bartyo/Device/Prototype/KiCAD-Files-SensorBoard/BOM_SPB_Go_Concept.xls

Part/Designator | Manufacturer Part Number/Seeed SKU | Quantity | Link
C1,C3,C4 | GRM155R60J475ME47D | 3 | https://www.digikey.com/
C2 | JMK107BJ106MA-T | 1 | https://www.digikey.com/
P1 | 61300911121 | 1 | https://www.digikey.com/
R1,R4 | RT0402BRD07200KL | 2 | https://www.digikey.com/
R2,R3 | ERA-2AED101X | 2 | https://www.digikey.com/
R5,R6,R7 | ERA-2AEB472X | 3 | https://www.digikey.com/
Rs1,Rs2 | ERJ-3RQF1R0V | 2 | https://www.digikey.com/
U1 | MAX30101EFD+T | 1 | https://www.digikey.com/
U2 | TLV70018DSER | 1 | https://www.digikey.com/
U3 | LTC6103CMS8#PBF | 1 | https://www.digikey.com/
