bartyo/Device/Prototype/KiCAD-Files-SensorBoard/Design-Files/SPB_ProjSante.kicad_pcb

## KiCad design Prototype/KiCAD-Files-SensorBoard/Design-Files/SPB_ProjSante.kicad_pcb (2019-10-11)

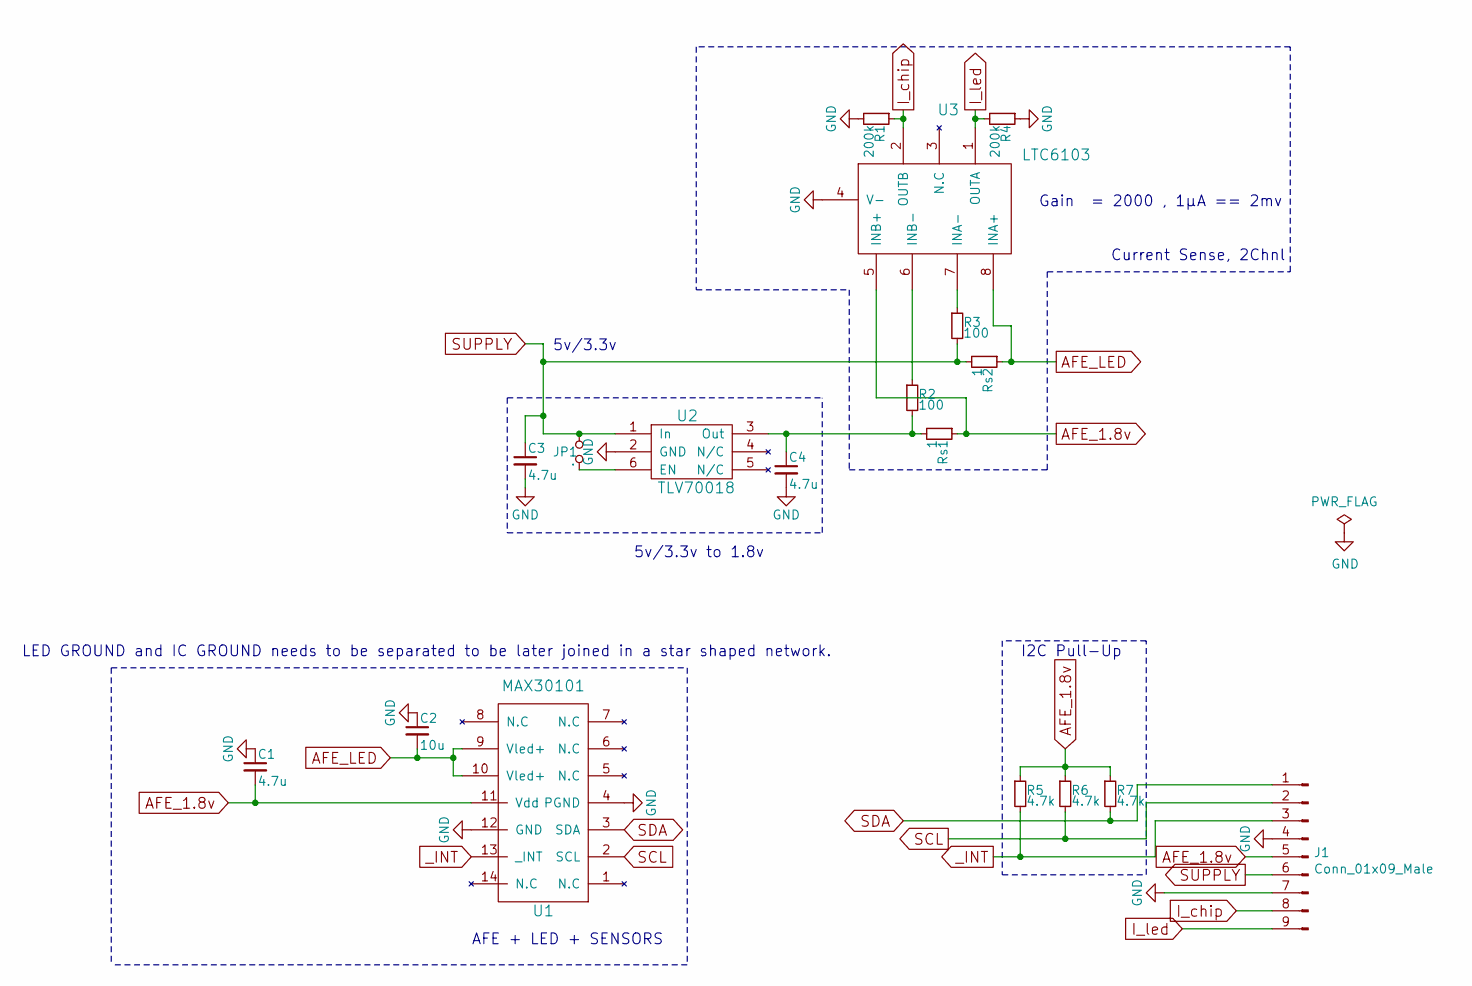
[picture p1: schematic SPB_ProjSante.sch, Sensor Prototype Board for Projet_Santé]

Parts:
C1, C3, C4: 4.7u; C_0402_1005Metric
C2: 10u; C_0603_1608Metric
J1: Conn_01x09_Male; PinHeader_1x09_P2.54mm_Vertical
JP1: .; C_0402_1005Metric
R1, R4: 200k; R_0402_1005Metric
R2, R3: 100; R_0402_1005Metric
R5, R6, R7: 4.7k; R_0402_1005Metric
Rs1, Rs2: 1; R_0603_1608Metric
U1: MAX30101; F134
U2: TLV70018; WSON-6_1.5x1.5mm_P0.5mm
U3: LTC6103; TSSOP-8_3x3mm_P0.65mm

Connections:
AFE_1.8v: C1.2, J1.5, R5.1, R6.1, R7.1, Rs1.1, U1.11 (Vdd), U3.5 (INB+)
AFE_LED: C2.2, Rs2.1, U1.9 (Vled+), U1.10 (Vled+), U3.8 (INA+)
GND: C1.1, C2.1, C3.2, C4.2, J1.4, J1.7, R1.2, R4.1, U1.4 (PGND), U1.12 (GND), U2.2 (GND), U3.4 (V-)
I_chip: J1.8, R1.1, U3.2 (OUTB)
I_led: J1.9, R4.2, U3.1 (OUTA)
unnamed: C4.1, R2.2, Rs1.2, U2.3 (Out)
unnamed: JP1.1, U2.6 (EN)
unnamed: R2.1, U3.6 (INB-)
unnamed: R3.1, U3.7 (INA-)
SCL: J1.2, R6.2, U1.2 (SCL)
SDA: J1.1, R7.2, U1.3 (SDA)
SUPPLY: C3.1, J1.6, JP1.2, R3.2, Rs2.2, U2.1 (In)
_INT: J1.3, R5.2, U1.13 (_INT)

Notes on the sheet:
I2C Pull-Up
Gain = 2000 , 1µA == 2mv
Current Sense, 2Chnl
5v/3.3v to 1.8v
5v/3.3v
AFE + LED + SENSORS
LED GROUND and IC GROUND needs to be separated to be later joined in a star shaped network.

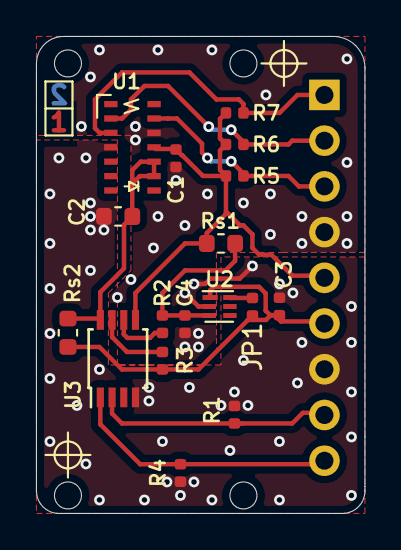
[picture p2: board SPB_ProjSante.kicad_pcb from above]

Board: 2 copper layers, 18.2 x 26.5 mm, 18 parts (1 on the bottom side), 13 nets.
