bartyo/Device/(commit log)

2019-10-23 Lots of stuffs
    Token functions + COM functions + Simulated GPIOs + Defines + Chip init.
    Still need to add :
    - I2C Init and Bluetooth init
    - BLE and GPIO alternatives
2019-10-24 Compact code, I2C Added, Setting TOKENS possible
